Ray0516/lumoPixel-ii/製作說明_compressed.pdf

# Lumo pixel II 製作說明

## 第一部分材料工具準備

# 需要準備的材料零件

esp32cam +燒錄板
電線(線徑1mm左右細線即可)
一台富士即可拍空殼（可選但建議準
備）補光燈版本
電阻100-150R 補光燈版本
一個5v2A充放電路（未焊接usb的）
一顆鋰電池範例型號402030
一顆1w的led燈珠,
兩個自鎖開關,
一個微控按鈕
一個有源蜂鳴器

需要的工具：
烙鐵,焊錫
黏著劑：熱熔膠,保麗龍膠,雙面膠
螺絲四個M2.5×8,一個M2.5×5

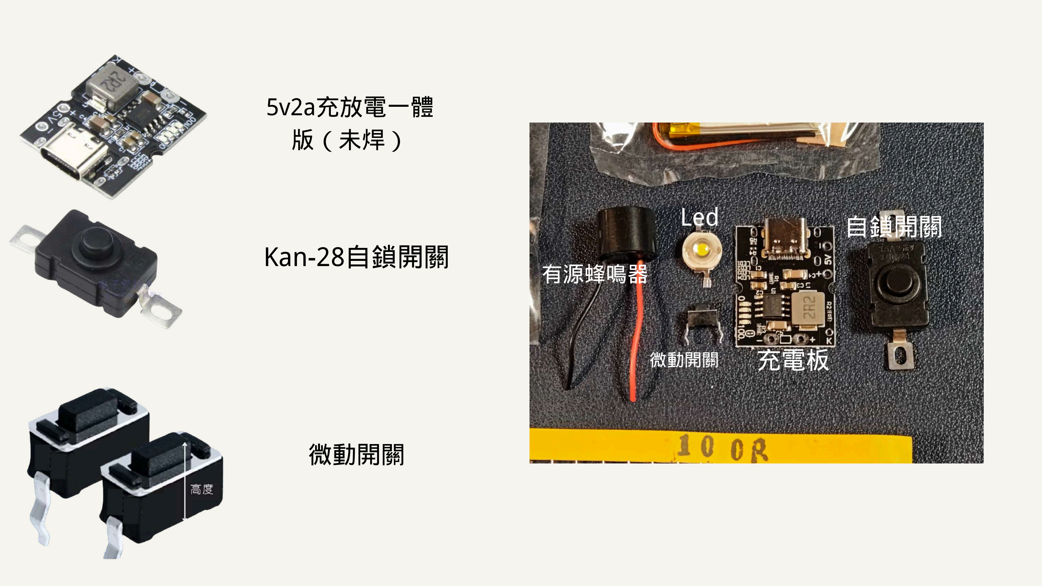
[picture p1: page 3]

充電板

Led

微動開關

有源蜂鳴器

自鎖開關
Kan-28自鎖開關

5v2a充放電一體
版（未焊）

微動開關

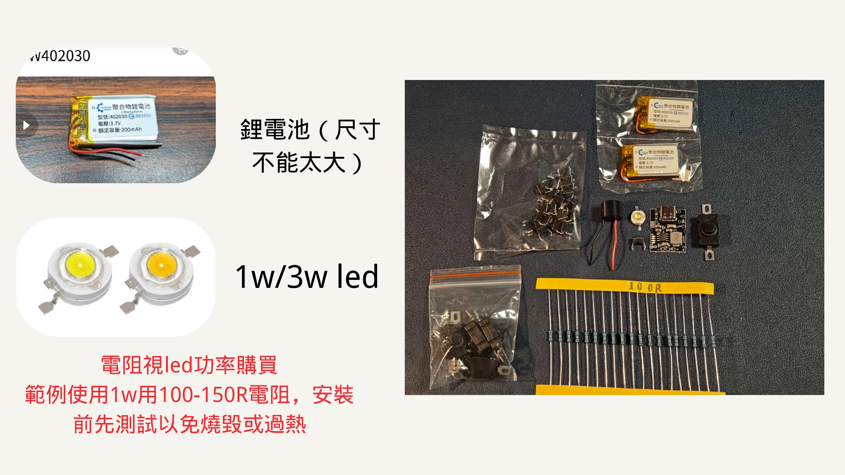
[picture p2: page 4]

鋰電池（尺寸
不能太大）

## 1w/3w led

電阻視led功率購買
範例使用1w用100-150R電阻，安裝
前先測試以免燒毀或過熱

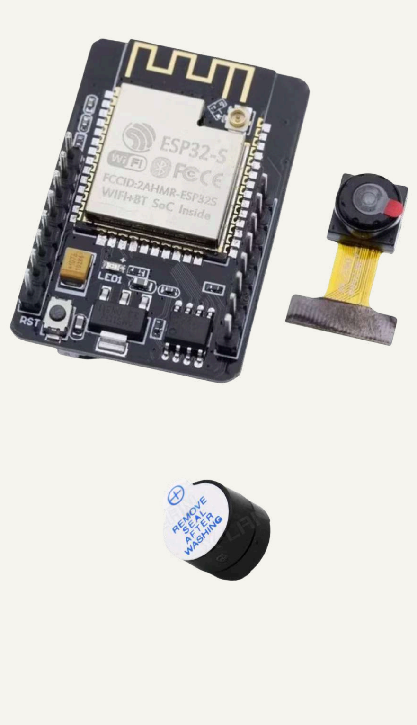
[picture p3: figure]

## Esp32 cam ov2640+燒錄器+傳輸線

### 有源蜂鳴器

# Lumo pixel II 製作說明

## 第二部分程式燒錄

## esp 32 cam程式燒錄

1.Arduino ide 下載👉
2.添加esp32 開發板參考👉
https://blog.jmaker.com.tw/esp32-setup/3.👇在工具-開發板-esp32-esp32 cam ai thinker https://github.com/Ray0516/lumoPixel-ii

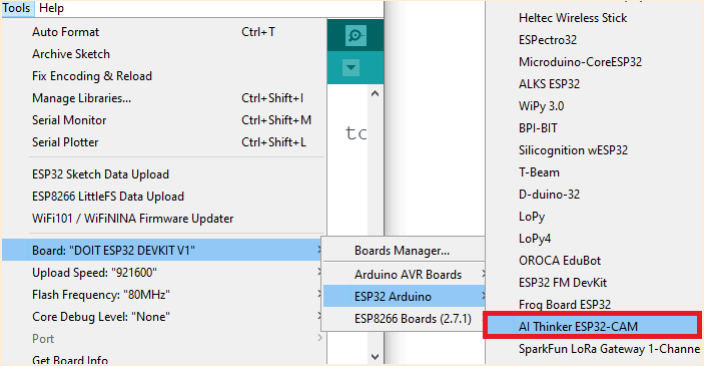
[picture p4: figure]

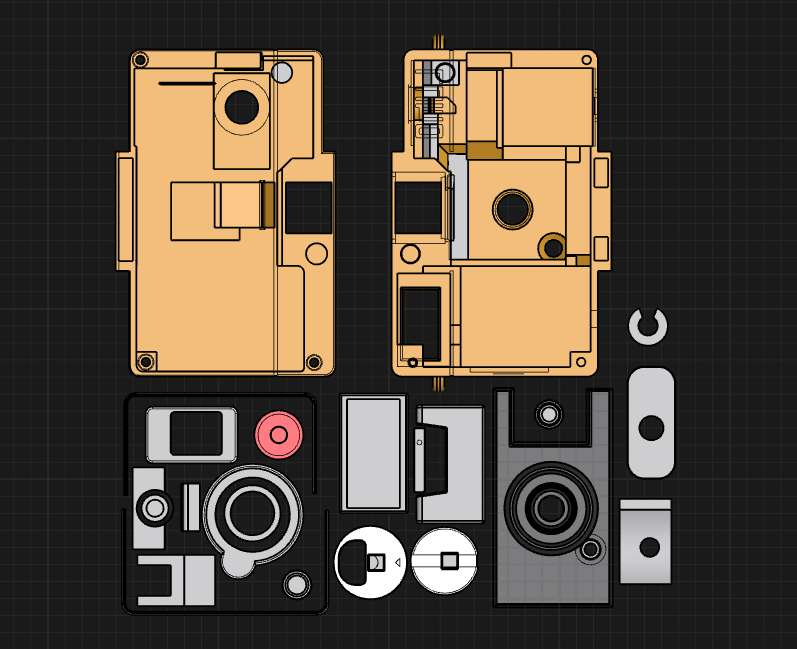
[picture p5: figure]

## 噴漆建議在電路安裝前進行

需要的工具：
烙鐵,焊錫
黏著劑：熱熔膠,保麗龍膠,雙面膠
螺絲四個M2.5×8,一個M2.5×5
外框線先黏貼再噴漆(正面邊框細線)

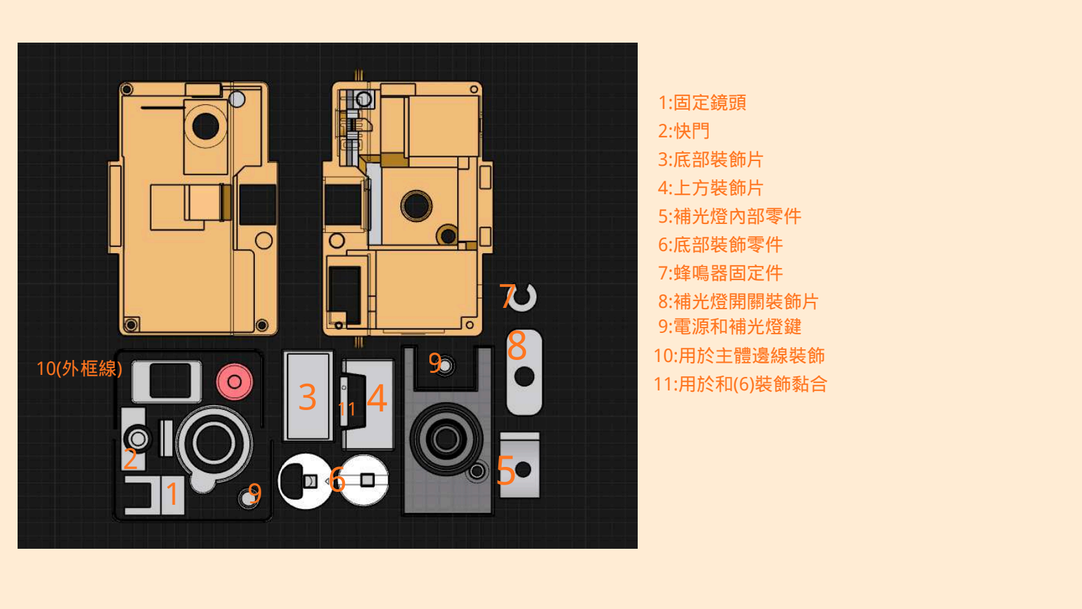
[picture p6: page 9]

1 2 | 3 4 6 | 5⁷8 9 ¹⁰⁽外框

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
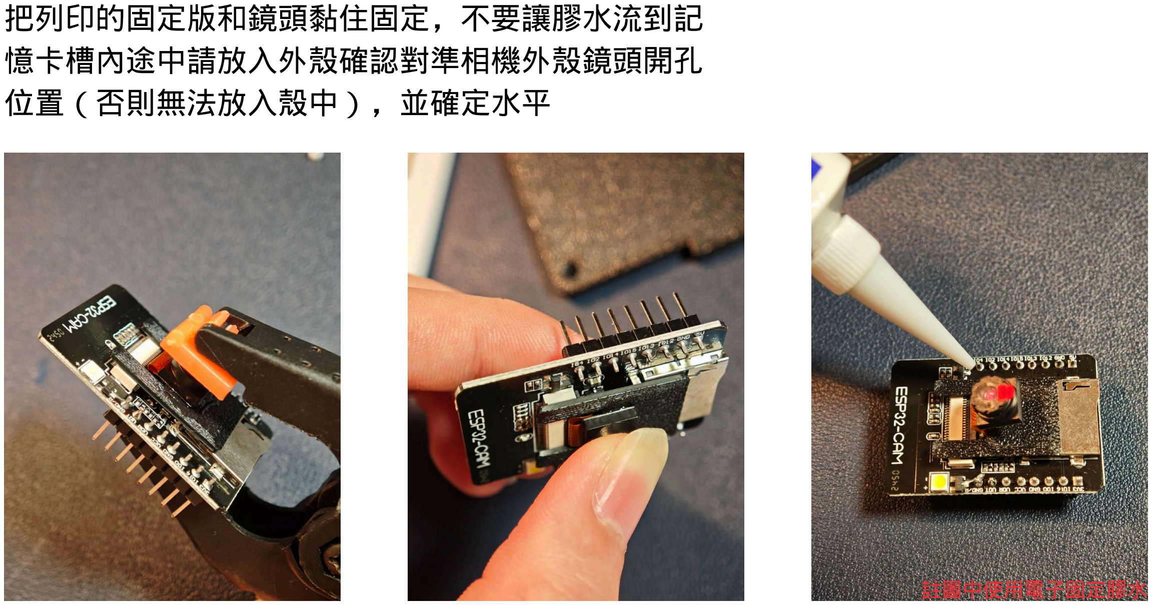
[picture p7: page 10]

把列印的固定版和鏡頭黏住固定，不要讓膠水流到記
憶卡槽內途中請放入外殼確認對準相機外殼鏡頭開孔
位置（否則無法放入殼中），並確定水平

註圖中使用電子固定膠水

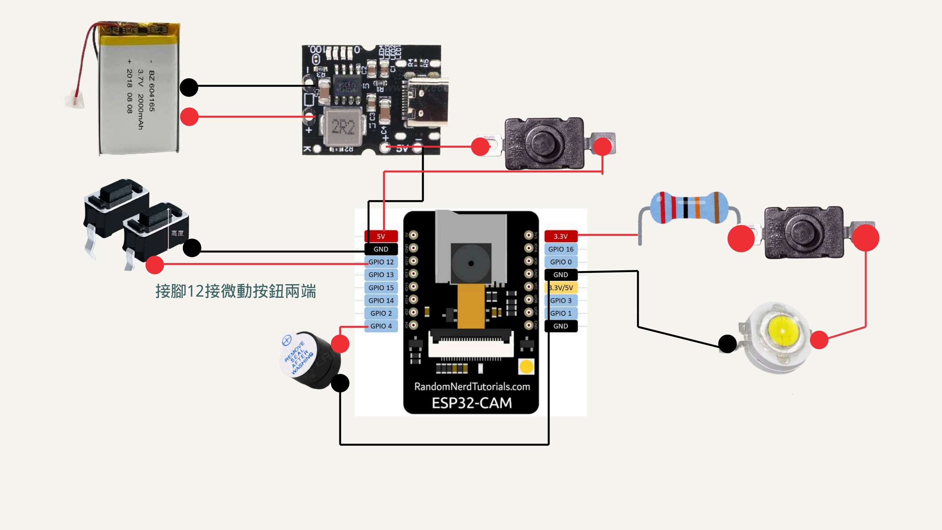
[picture p8: page 11]

接腳12接微動按鈕兩端

內部結構

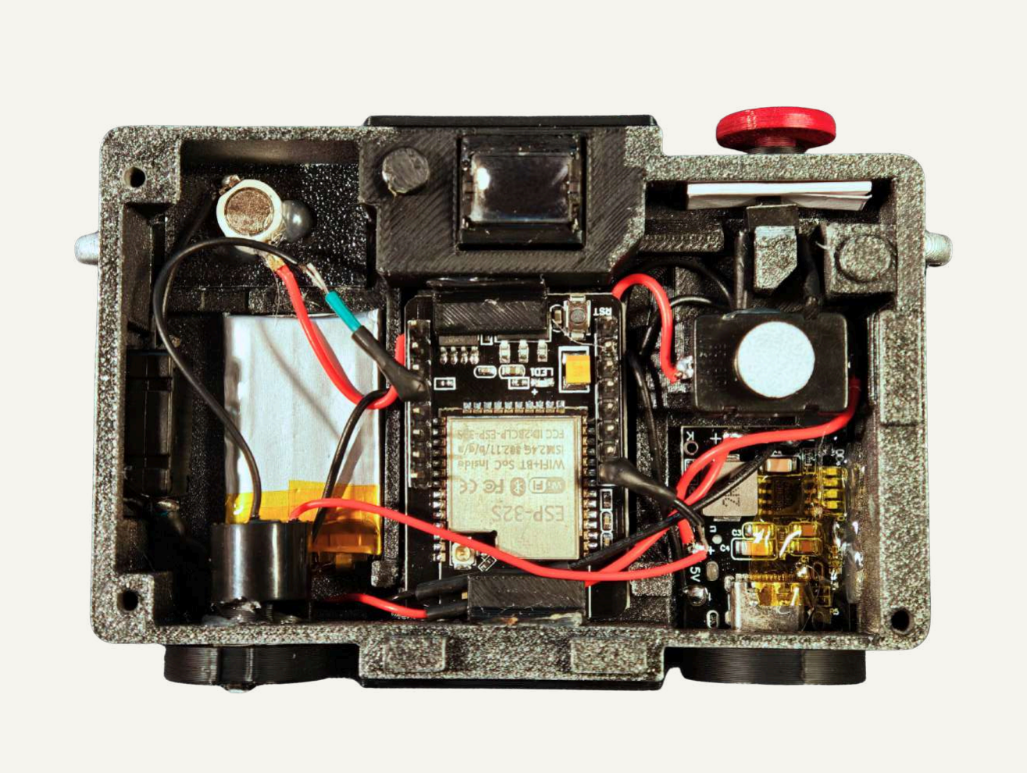
[picture p9: figure]
