Ray0516/lumoPixel-ii/取景器套件.3mf

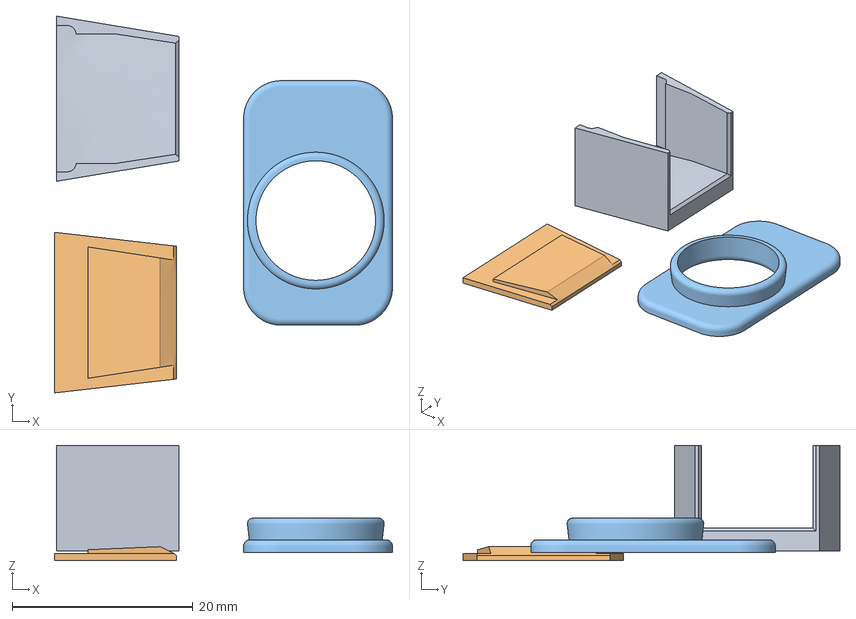
[picture p10: CAD file, 2026-03-14]
取景器套件.3mf
37.4 x 41.8 x 12.7 mm
