Ray0516/lumoPixel-ii/CHANGELOG.md

# 版本紀錄

## 1.1.1

- 新增 Flutter Android App 完整原始碼與 GitHub 自動檢查。
- 改用淺色 UI，移除裝飾標語，照片保留完整構圖。
- 增加全螢幕縮放與左右切換、多選、下載進度、停止下載及失敗重試。
- 支援像素、原圖、黑白、復古濾鏡；濾鏡參數及預設偏好可儲存。
- 濾鏡預覽及匯出共用色彩參數；原圖下載不重新壓縮。
- 對齊既有 ESP32 API，修正 SD 路徑重複拼接與檔名編碼。
- 保留舊版 App 識別碼與簽章，Android versionCode 更新為 3。
