Ray0516/lumoPixel-ii/(commit log)

2026-08-03 Add LUMO YI Android 16 camera app
2026-08-03 Revert "Add LUMO YI Android 16 camera app"
    This reverts commit bd77cc714e0bba7a020d4d85185260475b7897df.
